Nimfrodian/OverlordDimmer/other/Debug/README.txt

To use esp-prog you must first replace the driver via Zadig

1) Run Zadig
2) Options->List all devices
3) Select Dual RS232-HS (Interface 0)
4) Replace Driver

Once done you can start using the debugger via PlatformIO's "Run and Debug"
