Nimfrodian/OverlordDimmer/other/KiCad/OverlordDimmer/OverlordDimmer.kicad_pcb

## KiCad design other/KiCad/OverlordDimmer/OverlordDimmer.kicad_pcb (2025-06-15)

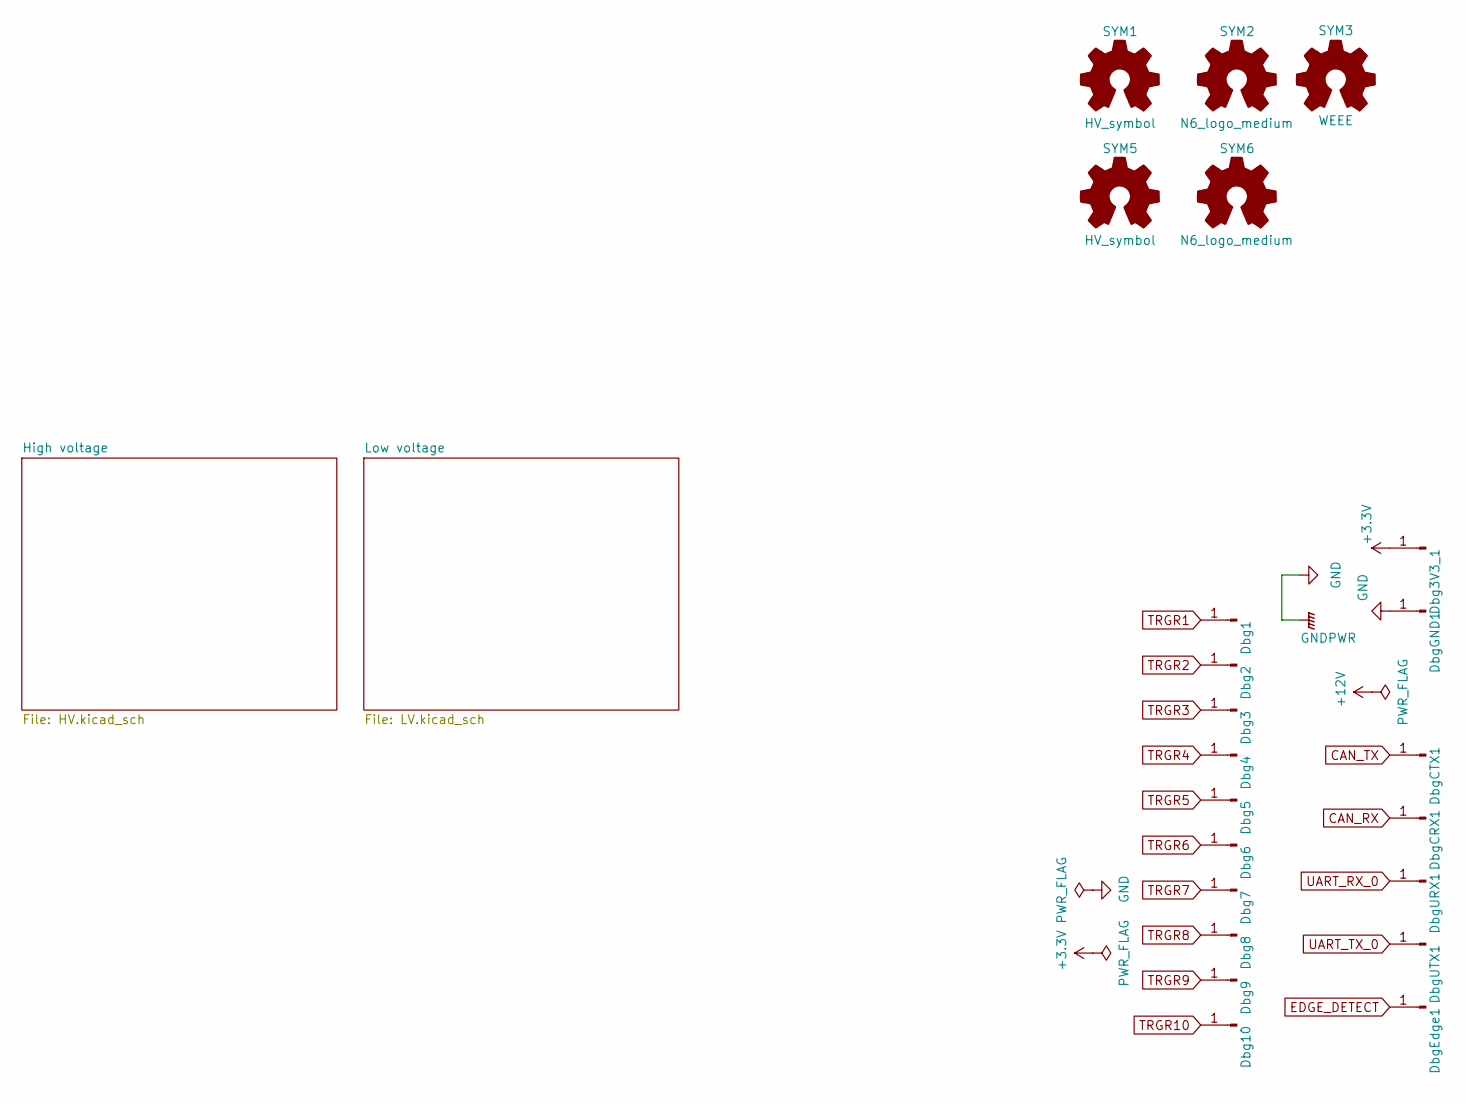
[picture p1: schematic OverlordDimmer.kicad_sch]

Parts:
Dbg1, Dbg2, Dbg3, Dbg3V3_1, Dbg4, Dbg5, Dbg6, Dbg7, Dbg8, Dbg9, Dbg10: Connector_Conn_01x01_Male; PinHeader_1x01_P2.54mm_Vertical
DbgCRX1: Connector_Conn_01x01_Male; PinHeader_1x01_P2.54mm_Vertical
DbgCTX1: Connector_Conn_01x01_Male; PinHeader_1x01_P2.54mm_Vertical
DbgEdge1: Connector_Conn_01x01_Male; PinHeader_1x01_P2.54mm_Vertical
DbgGND1: Connector_Conn_01x01_Male; PinHeader_1x01_P2.54mm_Vertical
DbgURX1: Connector_Conn_01x01_Male; PinHeader_1x01_P2.54mm_Vertical
DbgUTX1: Connector_Conn_01x01_Male; PinHeader_1x01_P2.54mm_Vertical
SYM1, SYM5: HV_symbol
SYM2, SYM6: N6_logo_medium; Symbol_N6Industries_medium
SYM3: WEEE; WEEE-Logo_5.6x8mm_SilkScreen

Connections:
+3.3V: Dbg3V3_1.1; also elsewhere on the board
CAN_RX: DbgCRX1.1; also elsewhere on the board
CAN_TX: DbgCTX1.1; also elsewhere on the board
EDGE_DETECT: DbgEdge1.1; also elsewhere on the board
GND: DbgGND1.1; also elsewhere on the board
TRGR1: Dbg1.1; also elsewhere on the board
TRGR2: Dbg2.1; also elsewhere on the board
TRGR3: Dbg3.1; also elsewhere on the board
TRGR4: Dbg4.1; also elsewhere on the board
TRGR5: Dbg5.1; also elsewhere on the board
TRGR6: Dbg6.1; also elsewhere on the board
TRGR7: Dbg7.1; also elsewhere on the board
TRGR8: Dbg8.1; also elsewhere on the board
TRGR9: Dbg9.1; also elsewhere on the board
TRGR10: Dbg10.1; also elsewhere on the board
UART_RX_0: DbgURX1.1; also elsewhere on the board
UART_TX_0: DbgUTX1.1; also elsewhere on the board

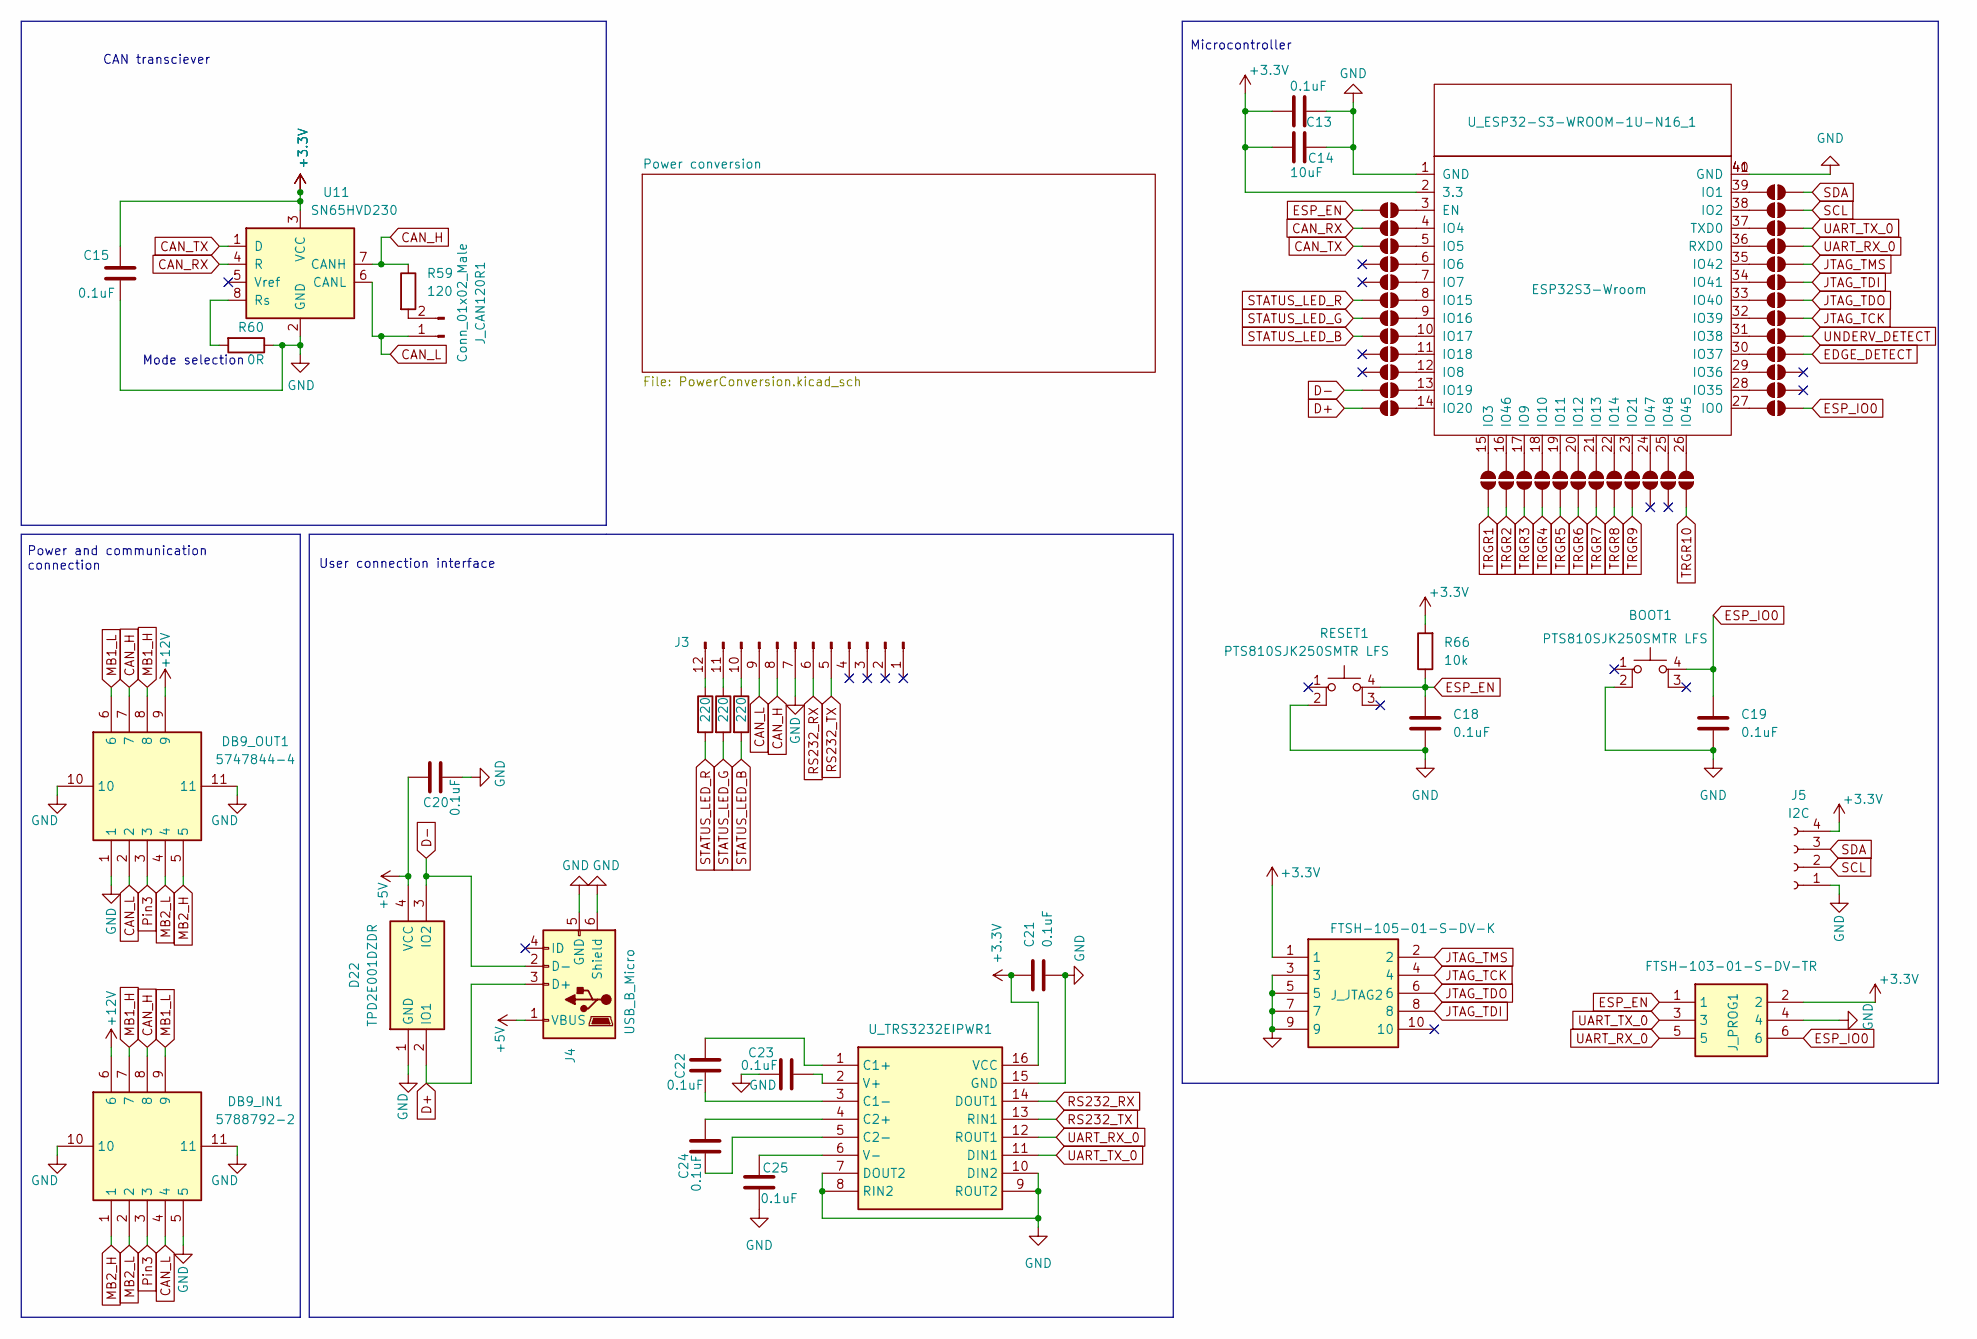
[picture p2: schematic LV.kicad_sch]

Parts:
BOOT1: PTS810SJK250SMTR LFS; PTS810SJK250SMTRLFS
C13, C15, C18, C19, C20, C21, C22, C23, C24, C25: 0.1uF; C_0805_2012Metric_Pad1.18x1.45mm_HandSolder
C14: 10uF; C_0805_2012Metric_Pad1.18x1.45mm_HandSolder
D22: TPD2E001DZDR; Mouser Part Number 595-TPD2E001DZDR
DB9_IN1: 5788792-2; 5788792; Mouser Part Number 571-5747844-4
DB9_OUT1: 5747844-4; 57478444; Mouser Part Number 571-5747844-4
J3: Conn_01x12_Pin; Molex_Picoflex_90325-0012_2x06_P1.27mm_Vertical
J4: USB_B_Micro; USB_Micro-B_Wuerth_614105150721_Vertical_CircularHoles
J5: I2C; PinHeader_1x04_P1.27mm_Vertical
JP1, JP2, JP3, JP4, JP5, JP6, JP7, JP8, JP9, JP10, JP11, JP12, JP13, JP14, JP15, JP16, JP17, JP18, JP19, JP20, JP21, JP22, JP23, JP24, JP25, JP26, JP27, JP28, JP29, JP30, JP31, JP32, JP33, JP34, JP35, JP36, JP37: SolderJumper_2_Open; SolderJumper-2_P1.3mm_Open_RoundedPad1.0x1.5mm
J_CAN120R1: Conn_01x02_Male; PinHeader_1x02_P2.54mm_Vertical
J_JTAG2: FTSH-105-01-S-DV-K; FTSH-105-XX-YYY-DV-K; Mouser Part Number 200-FTSH10501SDVK
J_PROG1: FTSH-103-01-S-DV-TR; FTSH-103-XX-YYY-DV-TR; Mouser Part Number 200-FTSH10301SDVTR
R59: 120; R_0805_2012Metric_Pad1.20x1.40mm_HandSolder
R60: 0R; R_0805_2012Metric_Pad1.20x1.40mm_HandSolder
R63, R64, R65: 220; R_0805_2012Metric_Pad1.20x1.40mm_HandSolder
R66: 10k; R_0805_2012Metric_Pad1.20x1.40mm_HandSolder
RESET1: PTS810SJK250SMTR LFS; PTS810SJK250SMTRLFS
U11: SN65HVD230; SOIC-8_3.9x4.9mm_P1.27mm
U_ESP32-S3-WROOM-1U-N16_1: ESP32S3-Wroom; ESP32-S3-WROOM-1U
U_TRS3232EIPWR1: TRS3232EIPWR; SOP65P640X120-16N; Mouser Part Number 595-TRS3232EIPWR

Connections:
+3.3V: C13.1, C14.1, C15.1, C21.1, J5.4, J_JTAG2.1, J_PROG1.2, R66.2, U11.3 (VCC), U_ESP32-S3-WROOM-1U-N16_1.2 (3.3), U_TRS3232EIPWR1.16 (VCC); also elsewhere on the board
+5V: C20.1, D22.4 (VCC), J4.1 (VBUS); also elsewhere on the board
+12V: DB9_IN1.6, DB9_OUT1.9; also elsewhere on the board
CAN_H: DB9_IN1.8, DB9_OUT1.7, J3.8, R59.1, U11.7 (CANH)
CAN_L: DB9_IN1.4, DB9_OUT1.2, J3.9, J_CAN120R1.1, U11.6 (CANL)
CAN_RX: JP4.2 (B), U11.4 (R); also elsewhere on the board
CAN_TX: JP6.2 (B), U11.1 (D); also elsewhere on the board
D+: D22.2 (IO1), J4.3 (D+), JP24.2 (B)
D-: D22.3 (IO2), J4.2 (D-), JP22.2 (B)
EDGE_DETECT: JP19.2 (B); also elsewhere on the board
ESP_EN: C18.1, JP2.2 (B), J_PROG1.1, R66.1, RESET1.4 (A)
ESP_IO0: BOOT1.4 (A), C19.1, JP25.2 (B), J_PROG1.6
GND: BOOT1.2, C13.2, C14.2, C15.2, C18.2, C19.2, C20.2, C21.2, C23.1, C25.1, D22.1 (GND), DB9_IN1.5, DB9_IN1.10, DB9_IN1.11, DB9_OUT1.1, DB9_OUT1.10, DB9_OUT1.11, J3.7, J4.5 (GND), J4.6 (Shield), J5.1, J_JTAG2.3, J_JTAG2.5, J_JTAG2.7, J_JTAG2.9, J_PROG1.4, R60.1, RESET1.2, U11.2 (GND), U_ESP32-S3-WROOM-1U-N16_1.1 (GND), U_ESP32-S3-WROOM-1U-N16_1.40 (GND), U_ESP32-S3-WROOM-1U-N16_1.41 (GND), U_TRS3232EIPWR1.7 (DOUT2), U_TRS3232EIPWR1.8 (RIN2), U_TRS3232EIPWR1.9 (ROUT2), U_TRS3232EIPWR1.10 (DIN2), U_TRS3232EIPWR1.15 (GND); also elsewhere on the board
JTAG_TCK: JP15.2 (B), J_JTAG2.4
JTAG_TDI: JP11.2 (B), J_JTAG2.8
JTAG_TDO: JP13.2 (B), J_JTAG2.6
JTAG_TMS: JP9.2 (B), J_JTAG2.2
MB1_H: DB9_IN1.7, DB9_OUT1.8
MB1_L: DB9_IN1.9, DB9_OUT1.6
MB2_H: DB9_IN1.1, DB9_OUT1.5
MB2_L: DB9_IN1.2, DB9_OUT1.4
unnamed: J3.10, R65.1
unnamed: J3.11, R64.1
unnamed: J3.12, R63.1
unnamed: JP1.1 (A), U_ESP32-S3-WROOM-1U-N16_1.39 (IO1)
unnamed: JP2.1 (A), U_ESP32-S3-WROOM-1U-N16_1.3 (EN)
unnamed: JP3.1 (A), U_ESP32-S3-WROOM-1U-N16_1.38 (IO2)
unnamed: JP4.1 (A), U_ESP32-S3-WROOM-1U-N16_1.4 (IO4)
unnamed: JP5.1 (A), U_ESP32-S3-WROOM-1U-N16_1.37 (TXD0)
unnamed: JP6.1 (A), U_ESP32-S3-WROOM-1U-N16_1.5 (IO5)
unnamed: JP7.1 (A), U_ESP32-S3-WROOM-1U-N16_1.36 (RXD0)
unnamed: JP8.1 (A), U_ESP32-S3-WROOM-1U-N16_1.6 (IO6)
unnamed: JP9.1 (A), U_ESP32-S3-WROOM-1U-N16_1.35 (IO42)
unnamed: JP10.1 (A), U_ESP32-S3-WROOM-1U-N16_1.7 (IO7)
unnamed: JP11.1 (A), U_ESP32-S3-WROOM-1U-N16_1.34 (IO41)
unnamed: JP12.1 (A), U_ESP32-S3-WROOM-1U-N16_1.8 (IO15)
unnamed: JP13.1 (A), U_ESP32-S3-WROOM-1U-N16_1.33 (IO40)
unnamed: JP14.1 (A), U_ESP32-S3-WROOM-1U-N16_1.9 (IO16)
unnamed: JP15.1 (A), U_ESP32-S3-WROOM-1U-N16_1.32 (IO39)
unnamed: JP16.1 (A), U_ESP32-S3-WROOM-1U-N16_1.10 (IO17)
unnamed: JP17.1 (A), U_ESP32-S3-WROOM-1U-N16_1.31 (IO38)
unnamed: JP18.1 (A), U_ESP32-S3-WROOM-1U-N16_1.11 (IO18)
unnamed: JP19.1 (A), U_ESP32-S3-WROOM-1U-N16_1.30 (IO37)
unnamed: JP20.1 (A), U_ESP32-S3-WROOM-1U-N16_1.12 (IO8)
unnamed: JP21.1 (A), U_ESP32-S3-WROOM-1U-N16_1.29 (IO36)
unnamed: JP22.1 (A), U_ESP32-S3-WROOM-1U-N16_1.13 (IO19)
unnamed: JP23.1 (A), U_ESP32-S3-WROOM-1U-N16_1.28 (IO35)
unnamed: JP24.1 (A), U_ESP32-S3-WROOM-1U-N16_1.14 (IO20)
unnamed: JP25.1 (A), U_ESP32-S3-WROOM-1U-N16_1.27 (IO0)
unnamed: JP26.1 (A), U_ESP32-S3-WROOM-1U-N16_1.15 (IO3)
unnamed: JP27.1 (A), U_ESP32-S3-WROOM-1U-N16_1.16 (IO46)
unnamed: JP28.1 (A), U_ESP32-S3-WROOM-1U-N16_1.17 (IO9)
unnamed: JP29.1 (A), U_ESP32-S3-WROOM-1U-N16_1.18 (IO10)
unnamed: JP30.1 (A), U_ESP32-S3-WROOM-1U-N16_1.19 (IO11)
unnamed: JP31.1 (A), U_ESP32-S3-WROOM-1U-N16_1.20 (IO12)
unnamed: JP32.1 (A), U_ESP32-S3-WROOM-1U-N16_1.21 (IO13)
unnamed: JP33.1 (A), U_ESP32-S3-WROOM-1U-N16_1.22 (IO14)
unnamed: JP34.1 (A), U_ESP32-S3-WROOM-1U-N16_1.23 (IO21)
unnamed: JP35.1 (A), U_ESP32-S3-WROOM-1U-N16_1.24 (IO47)
unnamed: JP36.1 (A), U_ESP32-S3-WROOM-1U-N16_1.25 (IO48)
unnamed: JP37.1 (A), U_ESP32-S3-WROOM-1U-N16_1.26 (IO45)
unnamed: J_CAN120R1.2, R59.2
unnamed: R60.2, U11.8 (Rs)
unnamed: C22.1, U_TRS3232EIPWR1.1 (C1+)
unnamed: C22.2, U_TRS3232EIPWR1.3 (C1-)
unnamed: C24.2, U_TRS3232EIPWR1.4 (C2+)
unnamed: C24.1, U_TRS3232EIPWR1.5 (C2-)
unnamed: C23.2, U_TRS3232EIPWR1.2 (V+)
unnamed: C25.2, U_TRS3232EIPWR1.6 (V-)
Pin3: DB9_IN1.3, DB9_OUT1.3
RS232_RX: J3.6, U_TRS3232EIPWR1.14 (DOUT1)
RS232_TX: J3.5, U_TRS3232EIPWR1.13 (RIN1)
SCL: J5.2, JP3.2 (B); also elsewhere on the board
SDA: J5.3, JP1.2 (B); also elsewhere on the board
STATUS_LED_B: JP16.2 (B), R65.2
STATUS_LED_G: JP14.2 (B), R64.2
STATUS_LED_R: JP12.2 (B), R63.2
TRGR1: JP26.2 (B); also elsewhere on the board
TRGR2: JP27.2 (B); also elsewhere on the board
TRGR3: JP28.2 (B); also elsewhere on the board
TRGR4: JP29.2 (B); also elsewhere on the board
TRGR5: JP30.2 (B); also elsewhere on the board
TRGR6: JP31.2 (B); also elsewhere on the board
TRGR7: JP32.2 (B); also elsewhere on the board
TRGR8: JP33.2 (B); also elsewhere on the board
TRGR9: JP34.2 (B); also elsewhere on the board
TRGR10: JP37.2 (B); also elsewhere on the board
UART_RX_0: JP7.2 (B), J_PROG1.5, U_TRS3232EIPWR1.12 (ROUT1); also elsewhere on the board
UART_TX_0: JP5.2 (B), J_PROG1.3, U_TRS3232EIPWR1.11 (DIN1); also elsewhere on the board
UNDERV_DETECT: JP17.2 (B); also elsewhere on the board

Notes on the sheet:
Power and communication connection
Microcontroller
Mode selection
CAN transciever
User connection interface

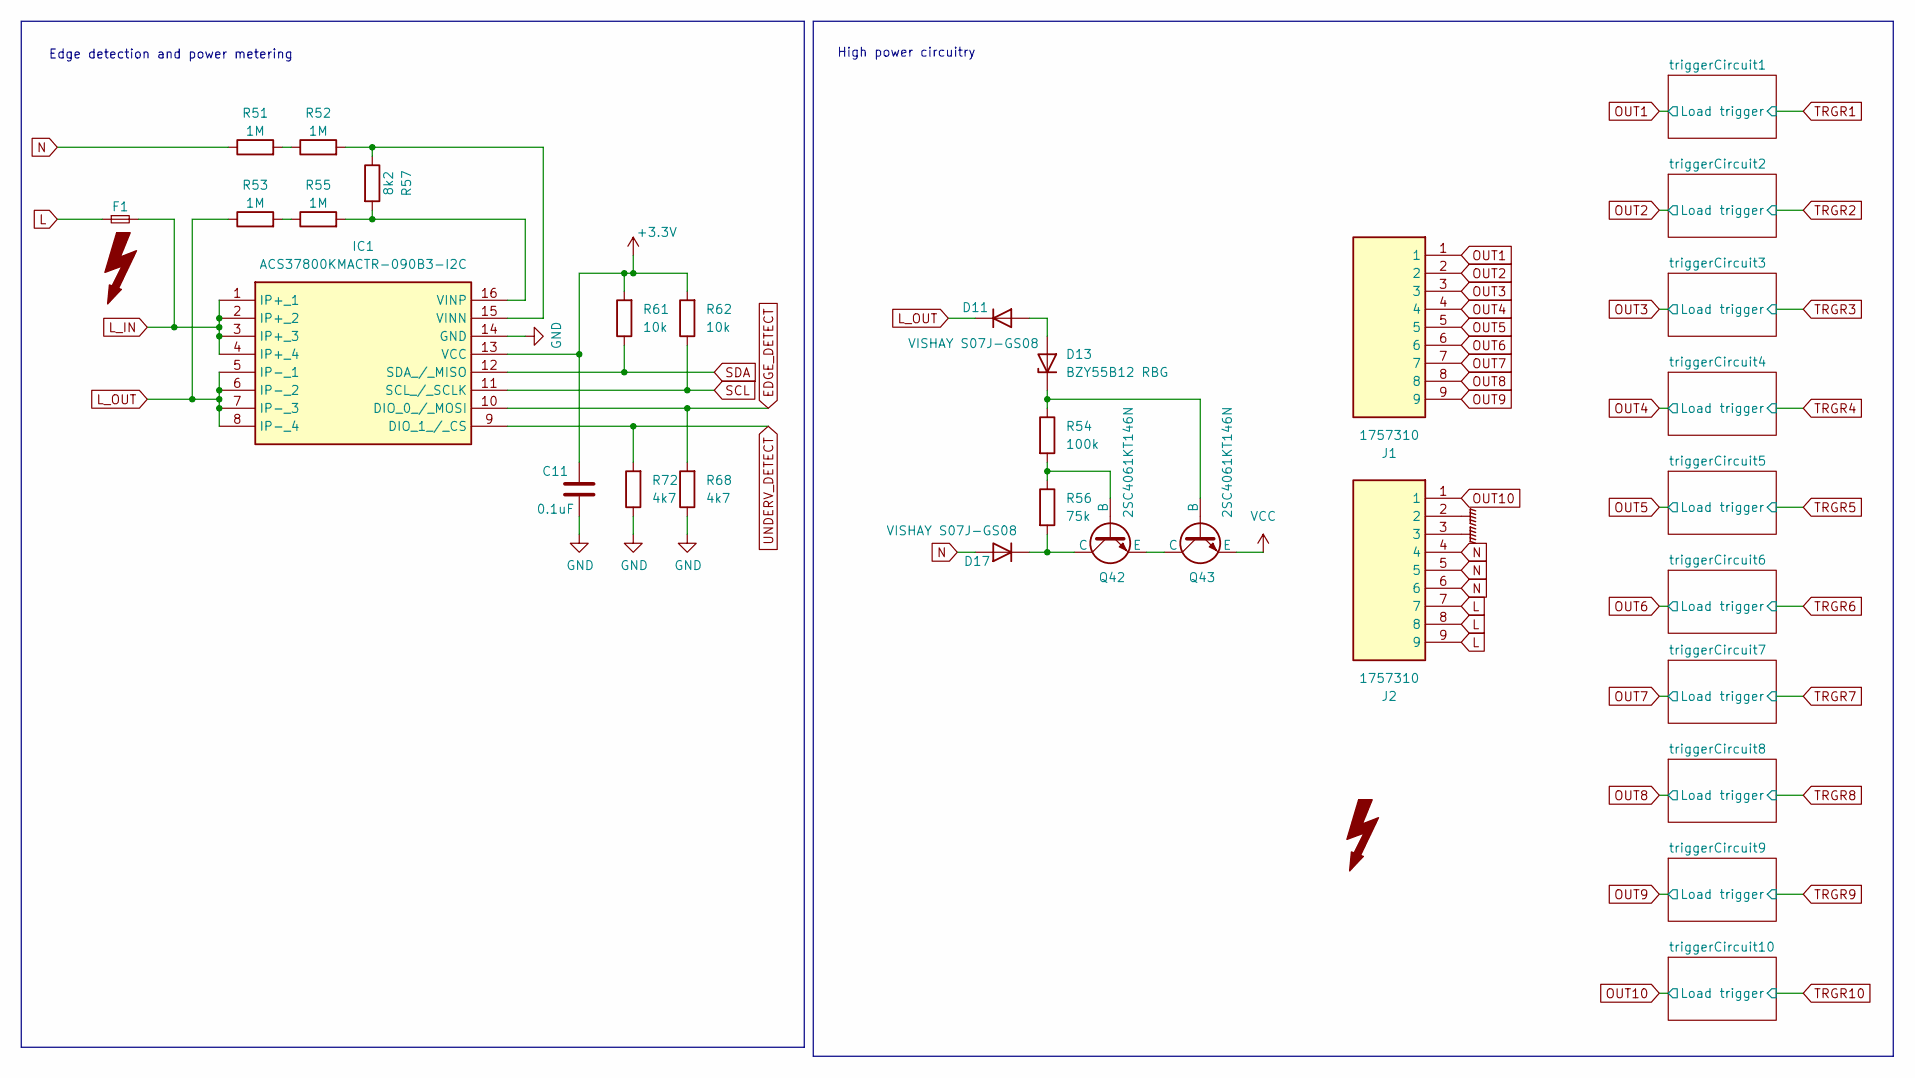
[picture p3: schematic HV.kicad_sch]

Parts:
C11: 0.1uF; C_0805_2012Metric_Pad1.18x1.45mm_HandSolder
D11, D17: VISHAY S07J-GS08; D_SMF
D13: BZY55B12 RBG; D_0805_2012Metric_Pad1.15x1.40mm_HandSolder
F1: Fuse_Small; Fuseholder_Clip-5x20mm_Bel_FC-203-22_Lateral_P17.80x5.00mm_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
IC1: ACS37800KMACTR-090B3-I2C; SOIC127P1030X265-16N; Mouser Part Number 250-KMACTR-090B3-I2C
J1, J2: 1757310; Mouser Part Number 651-1757310
Q42, Q43: 2SC4061KT146N; SC-59_Handsoldering
R51, R52, R53, R55: 1M; R_0805_2012Metric_Pad1.20x1.40mm_HandSolder
R54: 100k; R_0805_2012Metric_Pad1.20x1.40mm_HandSolder
R56: 75k; R_0805_2012Metric_Pad1.20x1.40mm_HandSolder
R57: 8k2; R_0805_2012Metric_Pad1.20x1.40mm_HandSolder
R61, R62: 10k; R_0805_2012Metric_Pad1.20x1.40mm_HandSolder
R68, R72: 4k7; R_0805_2012Metric_Pad1.20x1.40mm_HandSolder

Connections:
+3.3V: C11.1, IC1.13 (VCC), R61.2, R62.2; also elsewhere on the board
EDGE_DETECT: IC1.10 (DIO_0_/_MOSI), R68.2; also elsewhere on the board
GND: C11.2, IC1.14 (GND), J2.2, J2.3, R68.1, R72.1; also elsewhere on the board
L: F1.1, J2.7, J2.8, J2.9
L_IN: F1.2, IC1.1 (IP+_1), IC1.2 (IP+_2), IC1.3 (IP+_3), IC1.4 (IP+_4)
L_OUT: D11.1 (K), IC1.5 (IP-_1), IC1.6 (IP-_2), IC1.7 (IP-_3), IC1.8 (IP-_4), R53.1; also elsewhere on the board
N: D17.2 (A), J2.4, J2.5, J2.6, R51.1
unnamed: D11.2 (A), D13.2 (A)
unnamed: D13.1 (K), Q43.1 (B), R54.1
unnamed: D17.1 (K), Q42.3 (C), R56.2
unnamed: IC1.15 (VINN), R52.2, R57.1
unnamed: IC1.16 (VINP), R55.2, R57.2
unnamed: Q42.1 (B), R54.2, R56.1
unnamed: Q42.2 (E), Q43.3 (C)
unnamed: R51.2, R52.1
unnamed: R53.2, R55.1
OUT1: J1.1; also elsewhere on the board
OUT2: J1.2; also elsewhere on the board
OUT3: J1.3; also elsewhere on the board
OUT4: J1.4; also elsewhere on the board
OUT5: J1.5; also elsewhere on the board
OUT6: J1.6; also elsewhere on the board
OUT7: J1.7; also elsewhere on the board
OUT8: J1.8; also elsewhere on the board
OUT9: J1.9; also elsewhere on the board
OUT10: J2.1; also elsewhere on the board
SCL: IC1.11 (SCL_/_SCLK), R62.1; also elsewhere on the board
SDA: IC1.12 (SDA_/_MISO), R61.1; also elsewhere on the board
UNDERV_DETECT: IC1.9 (DIO_1_/_CS), R72.2; also elsewhere on the board
VCC: Q43.2 (E); also elsewhere on the board

Notes on the sheet:
Edge detection and power metering
High power circuitry

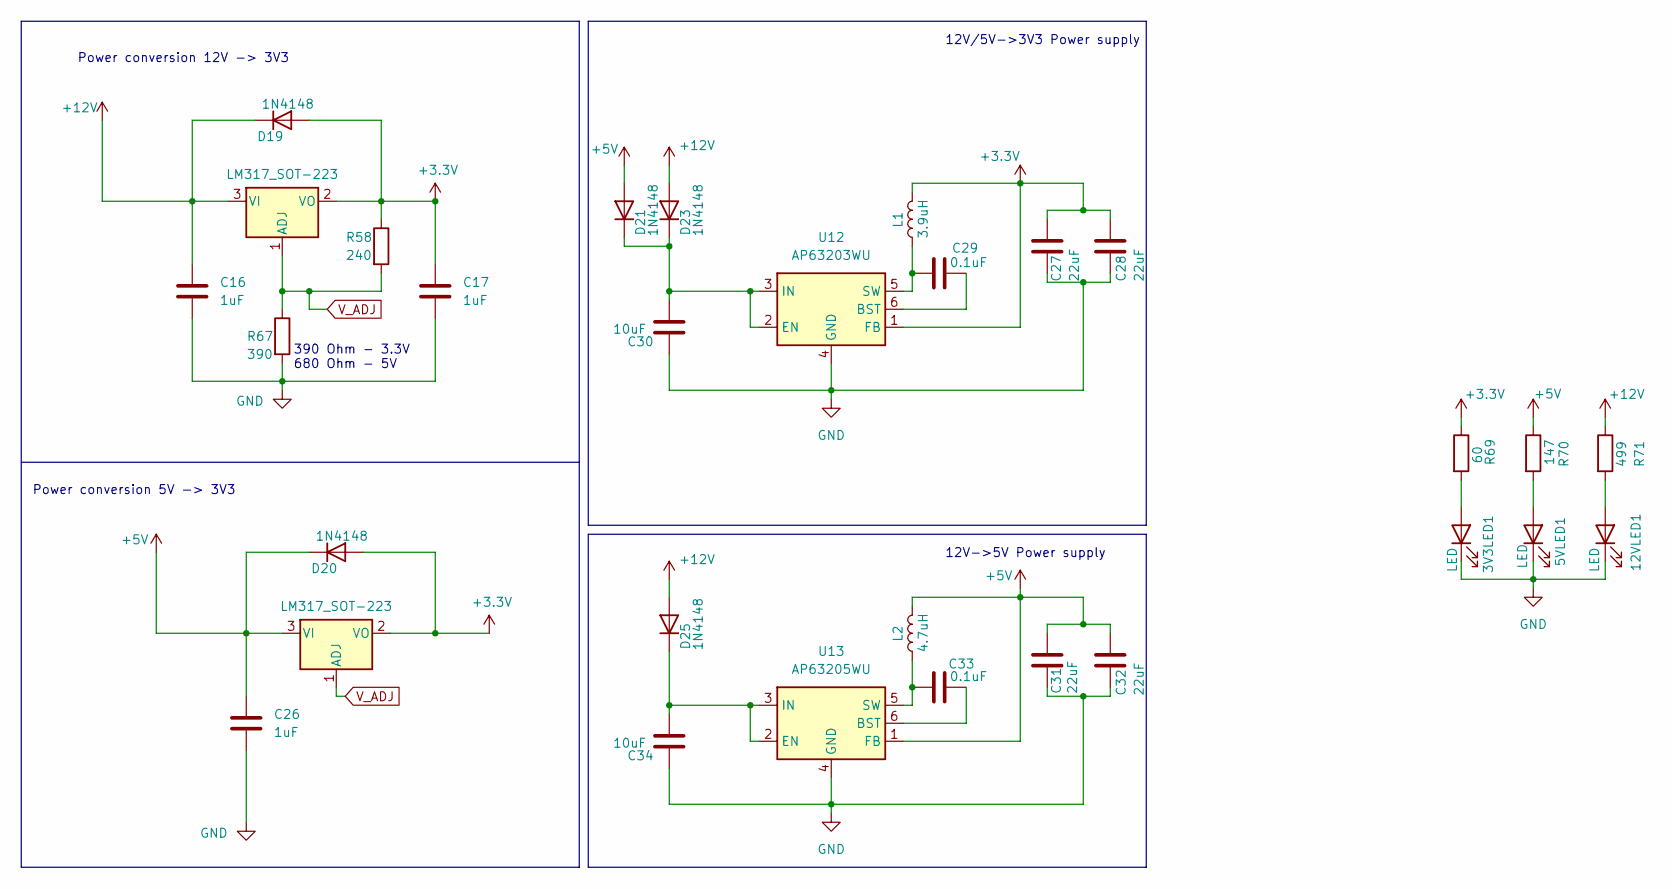
[picture p4: schematic PowerConversion.kicad_sch]

Parts:
3V3LED1, 5VLED1, 12VLED1: LED; LED_0805_2012Metric_Pad1.15x1.40mm_HandSolder
C16, C17, C26: 1uF; C_0805_2012Metric_Pad1.18x1.45mm_HandSolder
C27, C28, C31, C32: 22uF; C_0805_2012Metric_Pad1.18x1.45mm_HandSolder
C29, C33: 0.1uF; C_0805_2012Metric_Pad1.18x1.45mm_HandSolder
C30, C34: 10uF; C_0805_2012Metric_Pad1.18x1.45mm_HandSolder
D19, D20, D21, D23, D25: 1N4148; D_0805_2012Metric_Pad1.15x1.40mm_HandSolder
L1: 3.9uH; L_Bourns_SDR0604
L2: 4.7uH; L_Bourns_SDR0604
R58: 240; R_0805_2012Metric
R67: 390; R_0805_2012Metric
R69: 60; R_0805_2012Metric_Pad1.20x1.40mm_HandSolder
R70: 147; R_0805_2012Metric_Pad1.20x1.40mm_HandSolder
R71: 499; R_0805_2012Metric_Pad1.20x1.40mm_HandSolder
U12: AP63203WU; TSOT-23-6
U13: AP63205WU; TSOT-23-6
U_LM317_1, U_LM317_2: LM317_SOT-223; SOT-223-3_TabPin2

Connections:
+3.3V: C17.1, C27.1, C28.1, D19.2 (A), D20.2 (A), L1.2, R58.1, R69.1, U12.1 (FB), U_LM317_1.2 (VO), U_LM317_2.2 (VO); also elsewhere on the board
+5V: C26.1, C31.1, C32.1, D20.1 (K), D21.2 (A), L2.2, R70.1, U13.1 (FB), U_LM317_2.3 (VI); also elsewhere on the board
+12V: C16.1, D19.1 (K), D23.2 (A), D25.2 (A), R71.1, U_LM317_1.3 (VI); also elsewhere on the board
GND: 3V3LED1.1 (K), 5VLED1.1 (K), 12VLED1.1 (K), C16.2, C17.2, C26.2, C27.2, C28.2, C30.1, C31.2, C32.2, C34.1, R67.2, U12.4 (GND), U13.4 (GND); also elsewhere on the board
unnamed: 3V3LED1.2 (A), R69.2
unnamed: 5VLED1.2 (A), R70.2
unnamed: 12VLED1.2 (A), R71.2
unnamed: C30.2, D21.1 (K), D23.1 (K), U12.2 (EN), U12.3 (IN)
unnamed: C34.2, D25.1 (K), U13.2 (EN), U13.3 (IN)
unnamed: C29.2, U12.6 (BST)
unnamed: C29.1, L1.1, U12.5 (SW)
unnamed: C33.2, U13.6 (BST)
unnamed: C33.1, L2.1, U13.5 (SW)
V_ADJ: R58.2, R67.1, U_LM317_1.1 (ADJ), U_LM317_2.1 (ADJ)

Notes on the sheet:
390 Ohm - 3.3V 680 Ohm - 5V
12V->5V Power supply
12V/5V->3V3 Power supply
Power conversion 5V -> 3V3
Power conversion 12V -> 3V3

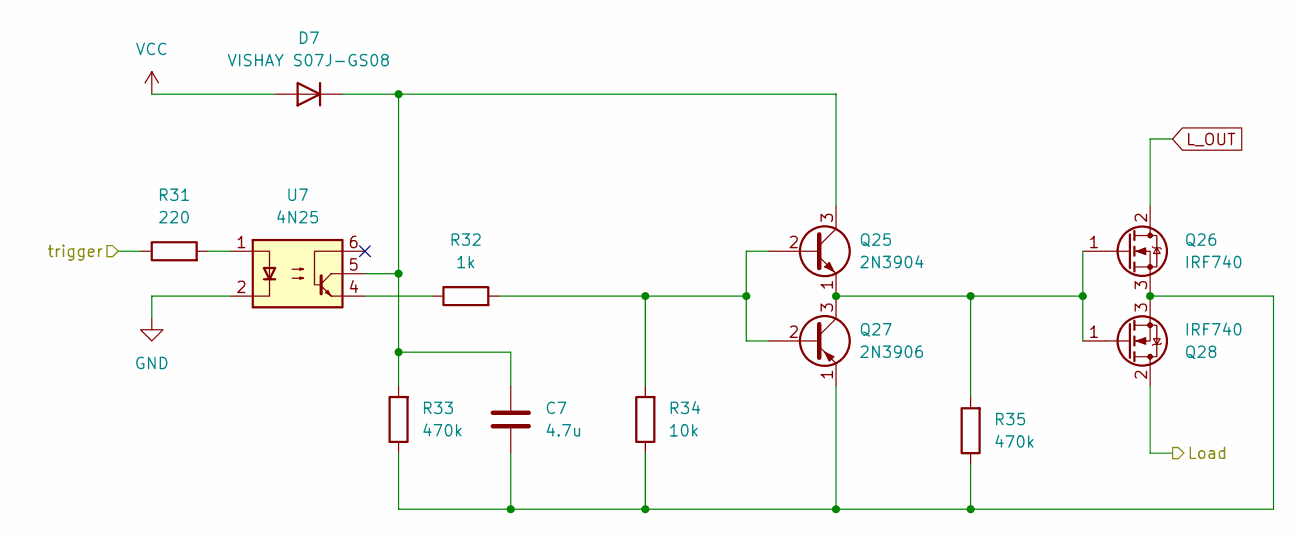
[picture p5: schematic triggerCircuit.kicad_sch]

Parts:
C7: 4.7u; C_1210_3225Metric_Pad1.33x2.70mm_HandSolder
D7: VISHAY S07J-GS08; D_SMF
Q25: 2N3904; TO-92_Inline
Q26, Q28: IRF740; TO-220-3_Vertical
Q27: 2N3906; TO-92_Inline
R31: 220; R_0805_2012Metric_Pad1.20x1.40mm_HandSolder
R32: 1k; R_0805_2012Metric_Pad1.20x1.40mm_HandSolder
R33, R35: 470k; R_0805_2012Metric_Pad1.20x1.40mm_HandSolder
R34: 10k; R_0805_2012Metric_Pad1.20x1.40mm_HandSolder
U7: 4N25; DIP-6_W7.62mm

Connections:
GND: U7.2; also elsewhere on the board
L_OUT: Q26.2 (D); also elsewhere on the board
unnamed: C7.1, D7.1 (K), Q25.3 (C), R33.2, U7.5
unnamed: Q25.2 (B), Q27.2 (B), R32.2, R34.2
unnamed: Q25.1 (E), Q26.1 (G), Q27.3 (C), Q28.1 (G), R35.2
unnamed: C7.2, Q26.3 (S), Q27.1 (E), Q28.3 (S), R33.1, R34.1, R35.1
unnamed: R31.2, U7.1
unnamed: R32.1, U7.4
OUT7: Q28.2 (D); also elsewhere on the board
TRGR7: R31.1; also elsewhere on the board
VCC: D7.2 (A); also elsewhere on the board

Parts of its further copies:
C1, C2, C3, C4, C5, C6, C8, C9, C10: 4.7u; C_1210_3225Metric_Pad1.33x2.70mm_HandSolder
D1, D2, D3, D4, D5, D6, D8, D9, D10: VISHAY S07J-GS08; D_SMF
Q1, Q5, Q9, Q13, Q17, Q21, Q29, Q33, Q37: 2N3904; TO-92_Inline
Q2, Q4, Q6, Q8, Q10, Q12, Q14, Q16, Q18, Q20, Q22, Q24, Q30, Q32, Q34, Q36, Q38, Q40: IRF740; TO-220-3_Vertical
Q3, Q7, Q11, Q15, Q19, Q23, Q31, Q35, Q39: 2N3906; TO-92_Inline
R1, R6, R11, R16, R21, R26, R36, R41, R46: 220; R_0805_2012Metric_Pad1.20x1.40mm_HandSolder
R2, R7, R12, R17, R22, R27, R37, R42, R47: 1k; R_0805_2012Metric_Pad1.20x1.40mm_HandSolder
R3, R5, R8, R10, R13, R15, R18, R20, R23, R25, R28, R30, R38, R40, R43, R45, R48, R50: 470k; R_0805_2012Metric_Pad1.20x1.40mm_HandSolder
R4, R9, R14, R19, R24, R29, R39, R44, R49: 10k; R_0805_2012Metric_Pad1.20x1.40mm_HandSolder
U1, U2, U3, U4, U5, U6, U8, U9, U10: 4N25; DIP-6_W7.62mm

Connections of its further copies:
GND: U1.2, U2.2, U3.2, U4.2, U5.2, U6.2, U8.2, U9.2, U10.2; also elsewhere on the board
L_OUT: Q2.2 (D), Q6.2 (D), Q10.2 (D), Q14.2 (D), Q18.2 (D), Q22.2 (D), Q30.2 (D), Q34.2 (D), Q38.2 (D); also elsewhere on the board
unnamed: C1.1, D1.1 (K), Q1.3 (C), R3.2, U1.5
unnamed: C2.1, D2.1 (K), Q5.3 (C), R8.2, U2.5
unnamed: C3.1, D3.1 (K), Q9.3 (C), R13.2, U3.5
unnamed: C4.1, D4.1 (K), Q13.3 (C), R18.2, U4.5
unnamed: C5.1, D5.1 (K), Q17.3 (C), R23.2, U5.5
unnamed: C6.1, D6.1 (K), Q21.3 (C), R28.2, U6.5
unnamed: C8.1, D8.1 (K), Q29.3 (C), R38.2, U8.5
unnamed: C9.1, D9.1 (K), Q33.3 (C), R43.2, U9.5
unnamed: C10.1, D10.1 (K), Q37.3 (C), R48.2, U10.5
unnamed: Q1.2 (B), Q3.2 (B), R2.2, R4.2
unnamed: Q1.1 (E), Q2.1 (G), Q3.3 (C), Q4.1 (G), R5.2
unnamed: C1.2, Q2.3 (S), Q3.1 (E), Q4.3 (S), R3.1, R4.1, R5.1
unnamed: Q5.2 (B), Q7.2 (B), R7.2, R9.2
unnamed: Q5.1 (E), Q6.1 (G), Q7.3 (C), Q8.1 (G), R10.2
unnamed: C2.2, Q6.3 (S), Q7.1 (E), Q8.3 (S), R8.1, R9.1, R10.1
unnamed: Q9.1 (E), Q10.1 (G), Q11.3 (C), Q12.1 (G), R15.2
unnamed: C3.2, Q10.3 (S), Q11.1 (E), Q12.3 (S), R13.1, R14.1, R15.1
unnamed: Q9.2 (B), Q11.2 (B), R12.2, R14.2
unnamed: Q13.2 (B), Q15.2 (B), R17.2, R19.2
unnamed: Q13.1 (E), Q14.1 (G), Q15.3 (C), Q16.1 (G), R20.2
unnamed: C4.2, Q14.3 (S), Q15.1 (E), Q16.3 (S), R18.1, R19.1, R20.1
unnamed: Q17.2 (B), Q19.2 (B), R22.2, R24.2
unnamed: Q17.1 (E), Q18.1 (G), Q19.3 (C), Q20.1 (G), R25.2
unnamed: C5.2, Q18.3 (S), Q19.1 (E), Q20.3 (S), R23.1, R24.1, R25.1
unnamed: Q21.2 (B), Q23.2 (B), R27.2, R29.2
unnamed: Q21.1 (E), Q22.1 (G), Q23.3 (C), Q24.1 (G), R30.2
unnamed: C6.2, Q22.3 (S), Q23.1 (E), Q24.3 (S), R28.1, R29.1, R30.1
unnamed: Q29.2 (B), Q31.2 (B), R37.2, R39.2
unnamed: Q29.1 (E), Q30.1 (G), Q31.3 (C), Q32.1 (G), R40.2
unnamed: C8.2, Q30.3 (S), Q31.1 (E), Q32.3 (S), R38.1, R39.1, R40.1
unnamed: Q33.2 (B), Q35.2 (B), R42.2, R44.2
unnamed: Q33.1 (E), Q34.1 (G), Q35.3 (C), Q36.1 (G), R45.2
unnamed: C9.2, Q34.3 (S), Q35.1 (E), Q36.3 (S), R43.1, R44.1, R45.1
unnamed: Q37.2 (B), Q39.2 (B), R47.2, R49.2
unnamed: Q37.1 (E), Q38.1 (G), Q39.3 (C), Q40.1 (G), R50.2
unnamed: C10.2, Q38.3 (S), Q39.1 (E), Q40.3 (S), R48.1, R49.1, R50.1
unnamed: R1.2, U1.1
unnamed: R2.1, U1.4
unnamed: R6.2, U2.1
unnamed: R7.1, U2.4
unnamed: R11.2, U3.1
unnamed: R12.1, U3.4
unnamed: R16.2, U4.1
unnamed: R17.1, U4.4
unnamed: R21.2, U5.1
unnamed: R22.1, U5.4
unnamed: R26.2, U6.1
unnamed: R27.1, U6.4
unnamed: R36.2, U8.1
unnamed: R37.1, U8.4
unnamed: R41.2, U9.1
unnamed: R42.1, U9.4
unnamed: R46.2, U10.1
unnamed: R47.1, U10.4
OUT1: Q4.2 (D); also elsewhere on the board
OUT2: Q8.2 (D); also elsewhere on the board
OUT3: Q12.2 (D); also elsewhere on the board
OUT4: Q16.2 (D); also elsewhere on the board
OUT5: Q20.2 (D); also elsewhere on the board
OUT6: Q24.2 (D); also elsewhere on the board
OUT8: Q32.2 (D); also elsewhere on the board
OUT9: Q36.2 (D); also elsewhere on the board
OUT10: Q40.2 (D); also elsewhere on the board
TRGR1: R1.1; also elsewhere on the board
TRGR2: R6.1; also elsewhere on the board
TRGR3: R11.1; also elsewhere on the board
TRGR4: R16.1; also elsewhere on the board
TRGR5: R21.1; also elsewhere on the board
TRGR6: R26.1; also elsewhere on the board
TRGR8: R36.1; also elsewhere on the board
TRGR9: R41.1; also elsewhere on the board
TRGR10: R46.1; also elsewhere on the board
VCC: D1.2 (A), D2.2 (A), D3.2 (A), D4.2 (A), D5.2 (A), D6.2 (A), D8.2 (A), D9.2 (A), D10.2 (A); also elsewhere on the board

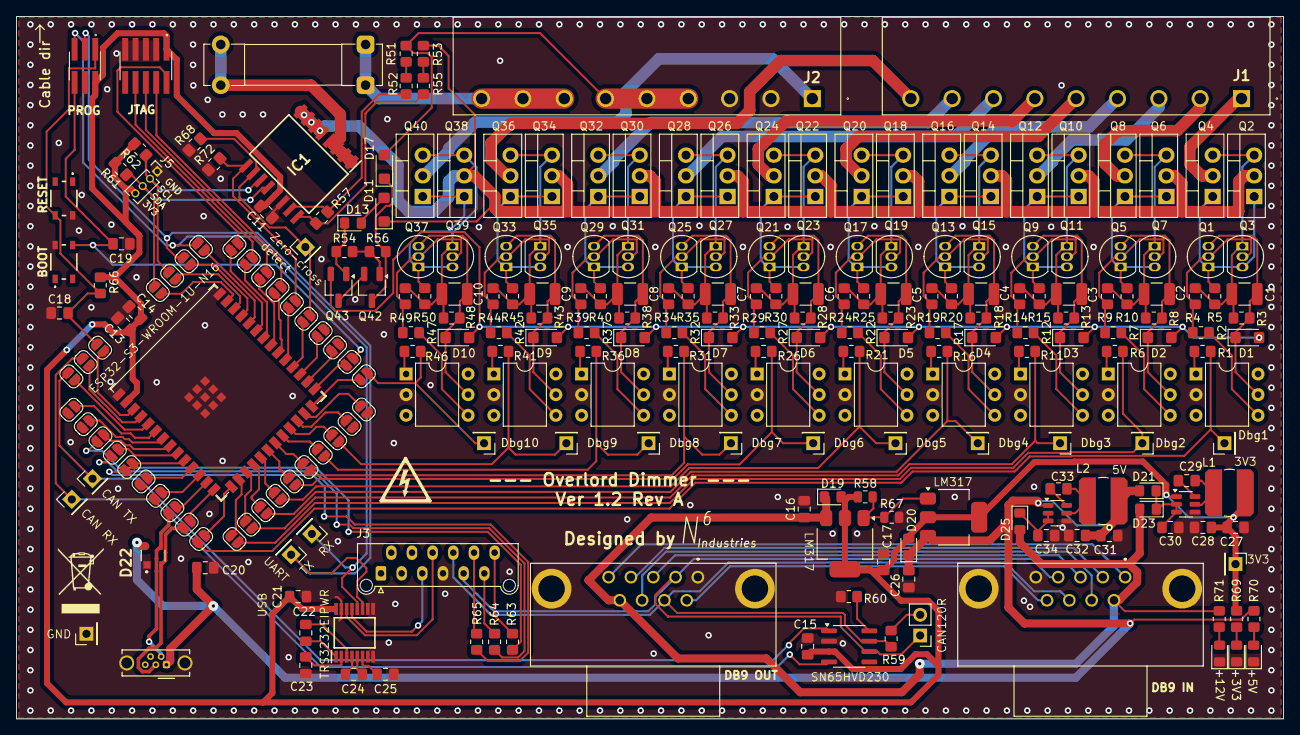
[picture p6: board OverlordDimmer.kicad_pcb from above]

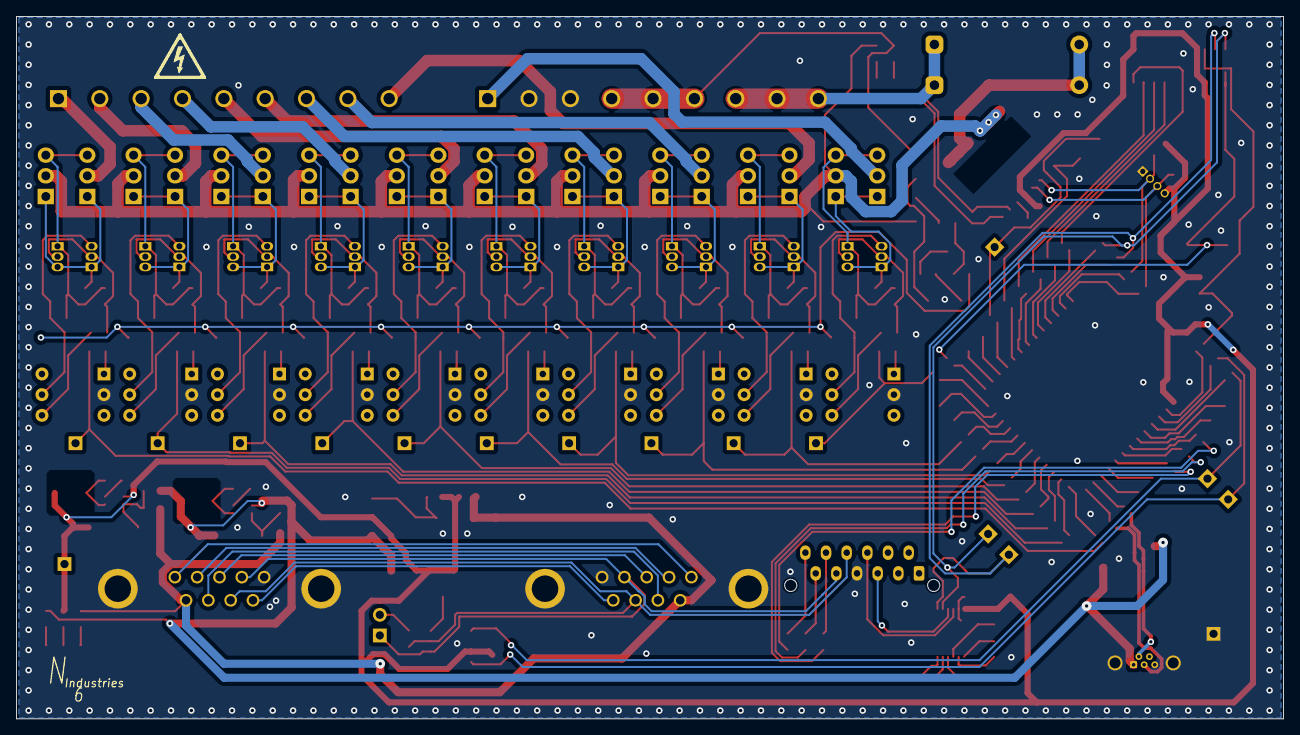
[picture p7: board OverlordDimmer.kicad_pcb from below]

Board: 2 copper layers, 155.7 x 86.3 mm, 261 parts (2 on the bottom side), 184 nets.
