Nimfrodian/OverlordDimmer/src/main.cpp

#include "main.h"

void main_run_5ms(void)
{
    {
        tCANM_X_CANMSGDATA_STR* rxDataPtr = canm_pstr_readCanMsgData(CAN_COMMAND_MESSAGE);
        if (1 == rxDataPtr->canRdyForParse_tB)
        {
            lgic_canMsgParse_ev( rxDataPtr->canMsg_str.data, &rxDataPtr->canMsg_str.identifier);
            canm_x_clearFlagForCanMsgParse(CAN_COMMAND_MESSAGE);
        }
    }
    {
        tCANM_X_CANMSGDATA_STR* rxDataPtr = canm_pstr_readCanMsgData(CAN_DMAS_COMMAND_MESSAGE);
        if (1 == rxDataPtr->canRdyForParse_tB)
        {
            dmas_canMsgParse_ev( rxDataPtr->canMsg_str.data, &rxDataPtr->canMsg_str.identifier);
            canm_x_clearFlagForCanMsgParse(CAN_DMAS_COMMAND_MESSAGE);
        }
    }

    {
        for (tU8 dmasMsgIndx = CAN_DMAS_SEND_MESSAGE0; dmasMsgIndx <= CAN_DMAS_SEND_MESSAGE15; dmasMsgIndx++)
        {
            tDMAS_MESSAGEDATA_STR preparedData = dmas_getReadyData();
            if (true == preparedData.isReady_U8)
            {
                tCANM_X_CANMSGDATA_STR* msgPtr_pstr = canm_pstr_readCanMsgData((tCANM_CANMSGINDX_E) dmasMsgIndx);
                msgPtr_pstr->canMsg_str.data[0] = preparedData.payload_U8[0];
                msgPtr_pstr->canMsg_str.data[1] = preparedData.payload_U8[1];
                msgPtr_pstr->canMsg_str.data[2] = preparedData.payload_U8[2];
                msgPtr_pstr->canMsg_str.data[3] = preparedData.payload_U8[3];
                msgPtr_pstr->canMsg_str.data[4] = preparedData.payload_U8[4];
                msgPtr_pstr->canMsg_str.data[5] = preparedData.payload_U8[5];
                msgPtr_pstr->canMsg_str.data[6] = preparedData.payload_U8[6];
                msgPtr_pstr->canMsg_str.data[7] = preparedData.payload_U8[7];

                msgPtr_pstr->canMsg_str.identifier = 0x20;
                msgPtr_pstr->canRdyForTx_tB = true;
            }
            else
            {
                break;
            }
        }
    }

    // 100ms tasks
    static uint32_t counter = 0;
    if (counter > 100)
    {
        tCANM_X_CANMSGDATA_STR* msgPtr0_pstr = canm_pstr_readCanMsgData(CAN_REPLY_MESSAGE0);
        tCANM_X_CANMSGDATA_STR* msgPtr1_pstr = canm_pstr_readCanMsgData(CAN_REPLY_MESSAGE1);
        msgPtr0_pstr->canMsg_str.identifier = 0x96;
        msgPtr1_pstr->canMsg_str.identifier = 0x97;

        lgic_canMsgCompose_100ms(msgPtr0_pstr->canMsg_str.data, &msgPtr0_pstr->canMsg_str.identifier);
        lgic_canMsgCompose_100ms(msgPtr1_pstr->canMsg_str.data, &msgPtr1_pstr->canMsg_str.identifier);

        canm_x_flagCanMsgForTx(CAN_REPLY_MESSAGE0);
        canm_x_flagCanMsgForTx(CAN_REPLY_MESSAGE1);
        counter = 0;

        tCANM_X_CANMSGDATA_STR* errh_canMsg0_pstr = canm_pstr_readCanMsgData(CAN_ERROR_MESSAGE0);
        tCANM_X_CANMSGDATA_STR* errh_canMsg1_pstr = canm_pstr_readCanMsgData(CAN_ERROR_MESSAGE1);
        tCANM_X_CANMSGDATA_STR* errh_canMsg2_pstr = canm_pstr_readCanMsgData(CAN_ERROR_MESSAGE2);
        tCANM_X_CANMSGDATA_STR* errh_canMsg3_pstr = canm_pstr_readCanMsgData(CAN_ERROR_MESSAGE3);

        errh_canMsg0_pstr->canMsg_str.identifier = 0x50;
        errh_canMsg1_pstr->canMsg_str.identifier = 0x51;
        errh_canMsg2_pstr->canMsg_str.identifier = 0x52;
        errh_canMsg3_pstr->canMsg_str.identifier = 0x53;

        uint8_t* canData_aU8[4] = {errh_canMsg0_pstr->canMsg_str.data,
                                   errh_canMsg1_pstr->canMsg_str.data,
                                   errh_canMsg2_pstr->canMsg_str.data,
                                   errh_canMsg3_pstr->canMsg_str.data,
                                   };

        if (true == errh_canMsgCompose_100ms(canData_aU8))
        {
            canm_x_flagCanMsgForTx(CAN_ERROR_MESSAGE0);
            canm_x_flagCanMsgForTx(CAN_ERROR_MESSAGE1);
            canm_x_flagCanMsgForTx(CAN_ERROR_MESSAGE2);
            canm_x_flagCanMsgForTx(CAN_ERROR_MESSAGE3);
        }
    }
    counter += MAIN_TI_ms_TASK_DELAY_U32;
}

extern "C" void app_main()
{
    pina_setGpioAsOutput(PINA_OUT_NUM_10);
    pina_setGpioAsOutput(PINA_OUT_NUM_11);
    pina_setGpioAsOutput(PINA_OUT_NUM_12);

    {
        tTMRA_INITDATA_STR TmraCfg =
        {};
        tmra_init(&TmraCfg);

        tERRH_INITDATA_STR ErrhCfg =
        {};
        errh_init(&ErrhCfg);

        tSERA_INITDATA_STR SeraCfg =
        {};
        sera_init(&SeraCfg);
        sera_print("Sera module initialized\n");

        tTRGD_INITDATA_STR TrgdCfg =
        {};
        trgd_init(&TrgdCfg);
        sera_print("Trgd module initialized\n");

        tCANM_INITDATA_STR CanmCfg =
        {};
        canm_init(&CanmCfg);
        sera_print("Canm module initialized\n");


        tRTDB_INITDATA_STR RtdbCfg =
        {};
        rtdb_init(&RtdbCfg);
        sera_print("Rtdb module initialized\n");


        tDMAS_INITDATA_STR DmasCfg =
        {};
        dmas_init(&DmasCfg);
        sera_print("DMAS module initialized\n");

        sera_print("Initialization time: %lli us\n", timh_ti_us_readSystemTime_S64());
    }

    while(true)
    {
        // MAIN_TI_ms_TASK_DELAY_U32 tasks
        main_run_5ms();

        canm_transceive_run_5ms();

        trgd_run_5ms();

        dmas_run_5ms();

        static tU8 main_st_led_U8 = 0;
        pina_setGpioLevel(PINA_OUT_NUM_10, (main_st_led_U8 >> 0) & 0x01);
        pina_setGpioLevel(PINA_OUT_NUM_11, (main_st_led_U8 >> 1) & 0x02);
        pina_setGpioLevel(PINA_OUT_NUM_12, (main_st_led_U8 >> 2) & 0x04);
        main_st_led_U8++;


        vTaskDelay(MAIN_TI_ms_TASK_DELAY_U32 / portTICK_PERIOD_MS);
    }
}
