Nimfrodian/OverlordDimmer/include/main.h

#pragma once

#include "espa.h"
#include "stdint.h"
#include "string.h"

#include "canm.h" ///< CAN module
#include "lgic.h" ///< Logic module
#include "trgd.h" ///< Triggering module
#include "rtdb.h" ///< Real Time Database module
#include "dmas.h" ///< Direct Memory Access Server module

#include "mdll.h" ///< Module List

#define MAIN_TI_ms_TASK_DELAY_U32 ((uint32_t) 5)
