Nimfrodian/OverlordDimmer/include/mdll.h

/*
*
* Module list file
*
*/
#pragma once

enum moduleList
{
    MODULE_INVALID = 0,
    MODULE_MAIN,

    // Lib
    MODULE_ERRH,
    MODULE_LGIC,
    MODULE_TIMH,

    // Src
    MODULE_CANM,
    MODULE_PINA,
    MODULE_SERA,
    MODULE_TMRA,
    MODULE_TRGD,
    MODULE_RTDB,
    MODULE_DMAS,
};
