Nimfrodian/OverlordDimmer/(commit log)

2023-12-13 added minimum time as the circuit is expected to trigger some microseconds early
2023-12-15 implemented triggering delay as the detection circuit fires early (before actual zero-cross)
2024-06-29 Reworked PCB for NMOS, i.e., trailing edge
    [OverlordDimmer.kicad_pcb, OverlordDimmer.kicad_sch, triggerCircuit.kicad_sch]
2024-07-06 Finalised ver1.0 revA of PCB
    [OverlordDimmer.csv, OverlordDimmer.kicad_pcb, OverlordDimmer.kicad_sch, triggerCircuit.kicad_sch]
2024-07-06 Added gerber files
    [OverlordDimmer-B_Cu.gbr, OverlordDimmer-B_Mask.gbr, OverlordDimmer-B_Paste.gbr, OverlordDimmer-B_Silkscreen.gbr, OverlordDimmer-Edge_Cuts.gbr, OverlordDimmer-F_Cu.gbr, OverlordDimmer-F_Mask.gbr, OverlordDimmer-F_Paste.gbr]
2024-07-12 Rewrote for mosfet, but not 100% reliable, WIP
2024-07-20 Rework for mosfet control, added unit testing (TODO: implement debugging of unit tests) TODO: - add dynamic adapting to changing cycle times
    [main.cpp]
2024-07-23 Added period compensation code TODO: debug issue where if several outputs are 100% they are not active for a short time on zero-crossing
    [main.cpp]
2024-08-03 WIP added CAN message rework
    [main.cpp]
2024-08-03 WIP further CAN message rework
    [main.cpp]
2024-08-03 rework complete, triggering much more reliable
    [main.cpp]
2024-08-09 replaced CAN module for espressif built-in twai module
    [canm.cpp, canm.h, espa.h, main.cpp, main.h]
2024-08-11 Added error handling module Updated test cases
    [canm.h, espa.h, main.h, pina.h]
2024-08-12 improved error handling errh 100% code coverage, unit tests pass
    [canm.cpp, canm.h, main.h, mdll.h, pina.cpp, pina.h, sera.cpp]
2024-08-13 updated serial abstraction, minor code fixes
    [main.cpp, sera.cpp, trgd.cpp]
2024-08-13 added CAN reporting of errors TODO: implement ISR safe way of error reporting
    [canm.h, main.cpp]
2024-11-23 Final commit from laptop
    [OverlordDimmer.kicad_pcb, OverlordDimmer.kicad_sch, triggerCircuit.kicad_sch]
2024-11-25 Updated for RTDB implementation and no-error on compilation
    [rtdb.c, trgd_rtdb_vars.h]
2025-01-18 uploadable code, serial communication OK TODO: check pin and functionality compatibility
    [OverlordDimmer.kicad_pcb, OverlordDimmer.kicad_sch, triggerCircuit.kicad_sch]
2025-01-29 Modified for S3 migration Prepared PCB for final inspection
    [HV.kicad_sch, LV.kicad_sch, OverlordDimmer.csv, OverlordDimmer.kicad_pcb, OverlordDimmer.kicad_sch, OverlordDimmer_BOM.csv, OverlordDimmer_BOM2.csv, triggerCircuit.kicad_sch]
2025-02-08 sent to production
    [HV.kicad_sch, LV.kicad_sch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]
2025-02-25 sent to production with fixes
    [LV.kicad_sch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]
2025-05-24 update to latest rtdb_gen
    [HV.kicad_sch, LV.kicad_sch, OverlordDimmer.kicad_pcb]
2025-06-15 Sent for PCB production, ver 1.2 rev A
    [HV.kicad_sch, LV.kicad_sch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]
2025-08-27 Updated PCB design - added pullup on boot pin GPIO0 - schematic cleanup - removed unused power supply parts
    [HV.kicad_sch, LV.kicad_sch, OverlordDimmer.kicad_sch, PowerConversion.kicad_sch, triggerCircuit.kicad_sch]
2025-09-25 minor kicad changes
